Dragonyx118/LegmaMiteo/firmware/LegmaMiteo_Documentazione_Firmware.docx

# LegmaMiteo — Firmware Stazione base

Stazione-001-V2 — BMP180 + SD + MQTT su TLS + Deep Sleep

# 1. Panoramica

Questo documento descrive il funzionamento del firmware della stazione meteo base del progetto LegmaMiteo, basato su ESP32-S3-WROOM-1-N16R8. La stazione legge un dato di temperatura/pressione dal sensore BMP180, lo invia via MQTT (su TLS, tramite Tailscale Funnel) e, se la rete non è disponibile, lo salva in coda su microSD per un invio successivo. Il ciclo di funzionamento si basa interamente sul deep sleep: ad ogni risveglio la scheda riparte da un reset completo (WiFi e MQTT si riconnettono da zero), mentre alcune variabili sopravvivono al sonno grazie alla RTC memory.

# 2. Architettura del ciclo

Non esiste un loop continuo: la funzione loop() non viene mai eseguita. Tutta la logica gira dentro setup(), che al termine chiama sempre goToDeepSleep(). Ad ogni risveglio la sequenza è:

- Avvio seriale e LED RGB (il colore precedente resta acceso finché non viene aggiornato)
- Impostazione del fuso orario (configTime), sempre, anche senza WiFi
- Inizializzazione I2C (BMP180) e SPI (microSD)
- Configurazione del client MQTT (server, buffer, timeout)
- Tentativo di connessione WiFi, poi MQTT
- Lettura del sensore e invio o salvataggio locale del dato live
- Se la connessione MQTT è attiva, invio del backlog accumulato su SD
- Disconnessione pulita e ingresso in deep sleep per il tempo restante del ciclo (10 secondi target)

# 3. Piedinatura (pin mapping)

Funzione | Pin GPIO | Note
I2C SDA (BMP180) | 4
I2C SCL (BMP180) | 5
SPI MISO (SD) | 16
SPI CLK (SD) | 17
SPI MOSI (SD) | 15
Chip Select SD | 18
LED RGB WS2812 | 48 | 38 su alcuni cloni (es. Freenove)

# 4. Gestione del tempo (NTP + fallback HTTP)

La sincronizzazione dell'orario avviene tramite NTP (time.google.com, con pool.ntp.org e time.cloudflare.com come server secondari passati a configTime). Il flag timeSynchronized, conservato in RTC memory, evita di ripetere la sincronizzazione NTP ad ogni ciclo una volta riuscita.

Se NTP fallisce (tipico su reti che filtrano UDP, come un hotspot Windows con ICS), il firmware tenta un fallback via HTTPS verso timeapi.io, che restituisce l'orario in JSON e lo imposta manualmente con settimeofday().

Nota importante: configTime() viene chiamato incondizionatamente all'inizio di ogni ciclo, anche se timeSynchronized è già true, altrimenti l'offset GMT+DST non verrebbe applicato correttamente nel boot corrente e i timestamp salvati su SD risulterebbero sfasati.

# 5. Connessione WiFi e diagnostica LED

La connessione WiFi viene tentata una sola volta per ciclo (nessun retry loop prolungato, per non consumare batteria). In caso di fallimento, il firmware distingue due situazioni tramite una scansione delle reti visibili (ssidVisibileInAria):

- Rete non rilevata nell'aria → LED viola/magenta (router spento o fuori portata)
- Rete rilevata ma connessione fallita → LED rosso (segnale instabile o credenziali errate)

In caso di successo, il colore del LED riflette la qualità del segnale (RSSI):

Colore | Significato | Condizione
Blu/Azzurro | Segnale WiFi perfetto | RSSI ≥ -55 dBm
Verde | Segnale WiFi ottimo | RSSI ≥ -65 dBm
Giallo | Segnale WiFi medio | RSSI ≥ -75 dBm
Rosso | Segnale WiFi scarso, oppure rete rilevata ma connessione fallita | RSSI < -75 dBm
Viola/Magenta | SSID configurato non rilevato nell'aria | Router spento o fuori portata
Arancione | WiFi OK ma broker MQTT non raggiungibile | Server/tunnel/credenziali

# 6. Connessione MQTT su TLS

Il broker MQTT è raggiunto tramite Tailscale Funnel in modalità tls-terminated-tcp: dall'esterno risulta un endpoint pubblico su porta 8443, con TLS terminato da Tailscale usando un certificato pubblico valido. Internamente il traffico prosegue in chiaro verso Mosquitto sulla porta 1883.

Nel firmware questo si traduce in un normale WiFiClientSecure. Attualmente è impostato setInsecure(), che salta la verifica del certificato: utile in fase di test, ma per un deployment definitivo andrebbe sostituito con setCACert() puntato alla root CA reale. Il timeout del client è impostato a 10 secondi per assorbire il tempo aggiuntivo dell'handshake TLS.

Se il WiFi funziona ma la connessione MQTT fallisce, il LED passa ad arancione: questo colore è distinto dalla scala verde/giallo/rosso del segnale WiFi, perché segnala un problema più a monte (server spento, tunnel caduto, credenziali errate) e non di potenza del segnale.

# 7. Gestione del backlog su microSD

Quando l'invio MQTT non è possibile, il dato viene scritto in append nel file /backup.jsonl (una riga JSON per lettura). Quando la connessione torna disponibile, la funzione svuotaCodaSD() invia i dati accumulati.

Il punto chiave dell'ottimizzazione è l'offset persistente sdReadOffset, salvato in RTC memory: invece di ricopiare l'intero file ad ogni ciclo, il firmware riprende la lettura esattamente da dove si era fermato con file.seek(sdReadOffset). Questo ha ridotto il tempo di ciclo da circa 43 secondi a circa 7 secondi nei test.

Alcuni dettagli di comportamento:

- L'invio da SD ha un budget di tempo di 6 secondi per ciclo (SD_FLUSH_TIME_BUDGET_MS), non un numero fisso di righe: con connessione buona vengono inviati più dati nello stesso tempo
- Tra un invio e l'altro c'è una pausa di 50ms per non sovraccaricare la pipeline Mosquitto → Telegraf → InfluxDB → Grafana
- L'offset avanza SOLO dopo un invio riuscito: se la connessione cade a metà, la riga non inviata viene ritentata al ciclo successivo
- Se il file viene svuotato completamente, viene eliminato subito con SD.remove()
- Una compattazione fisica del file avviene solo periodicamente, ogni 200KB di dati processati (SD_COMPACT_THRESHOLD_BYTES), per ammortizzare il costo della riscrittura su molti cicli invece di farla ogni volta

# 8. Acquisizione dati e pubblicazione

La funzione handleDataCycle() legge temperatura e pressione dal BMP180 e costruisce un payload JSON con ArduinoJson. I campi di umidità, luce, vento e pioggia sono presenti nello schema ma non ancora popolati da sensori reali (impostati a 0.0), in previsione dei moduli aggiuntivi MOD-AIR e sensori esterni.

Se la connessione MQTT è attiva, il dato viene pubblicato subito sul topic station/<STATION_ID>/base. Solo se la pubblicazione fallisce o MQTT non è disponibile, il dato viene scritto su SD. La lettura live viene sempre gestita prima dello svuotamento del backlog SD, per evitare che un backlog lungo ritardi il dato più recente.

# 9. Deep sleep e durata del ciclo

Il ciclo target è di 10 secondi (CYCLE_DURATION_US). La funzione goToDeepSleep() calcola quanto tempo è stato effettivamente impiegato in fase attiva (boot, connessioni, lettura sensore, invio dati) e sottrae questo valore dalla durata target, così l'intervallo tra due letture resta vicino ai 10 secondi indipendentemente da quanto tempo la scheda è rimasta sveglia. È previsto un tempo minimo di sonno di 2 secondi come garanzia di sicurezza.

Il LED RGB non viene spento prima del deep sleep: mantiene l'ultimo colore mostrato, restando visibile anche durante il sonno senza bisogno di alimentazione continua sul pin.

# 10. Osservazioni per il miglioramento della stabilità

Punti da tenere presenti per rendere la connessione della stazione più stabile:

- setInsecure() su MQTT va sostituito con setCACert() per una verifica certificato reale in produzione
- Il singolo tentativo di connessione WiFi/MQTT per ciclo (8 tentativi da 500ms) è volutamente breve per risparmiare batteria: in caso di reti instabili, si potrebbe valutare un numero di retry variabile o un backoff
- Il timeout MQTT di 10s con TLS può risultare stretto su reti molto lente; da monitorare in campo
- Il buffer PubSubClient è impostato a 512 byte per l'overhead TLS: da verificare se sufficiente con payload più grandi (es. MOD-AIR con più sensori)
- La sincronizzazione NTP viene ritentata solo se timeSynchronized è false: un power-cycle completo (non solo deep sleep) resetta questo flag
