Dragonyx118/LegmaMiteo/3Dmodels/anemometer-wind-direction/MainSeal.stl

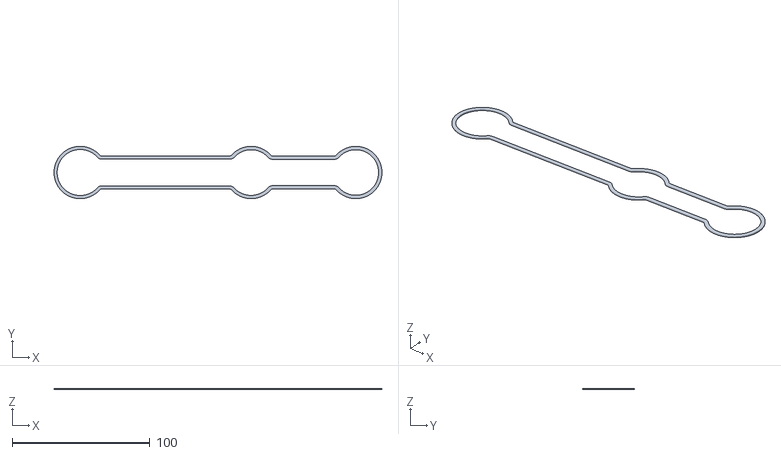
[picture p4: CAD file, 2026-11-05]
3Dmodels/anemometer-wind-direction/MainSeal.stl
238.0 x 38.0 x 1.00
