Dragonyx118/LegmaMiteo/3Dmodels/anemometer-wind-direction/WindVaneSeal.stl

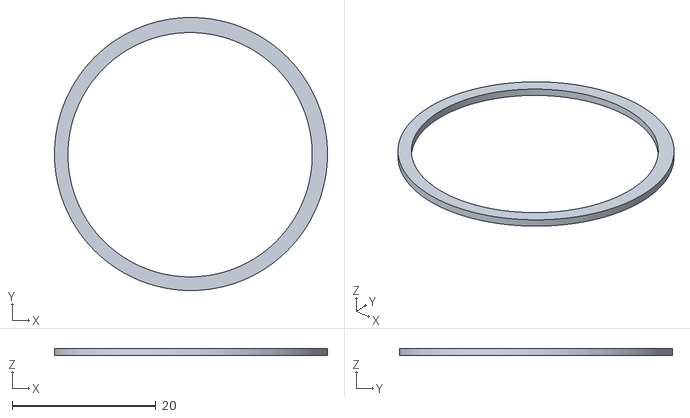
[picture p5: CAD file, 2026-11-05]
3Dmodels/anemometer-wind-direction/WindVaneSeal.stl
38.0 x 38.0 x 1.00
