Dragonyx118/LegmaMiteo/3Dmodels/rain-gauge/RainSeals.3mf

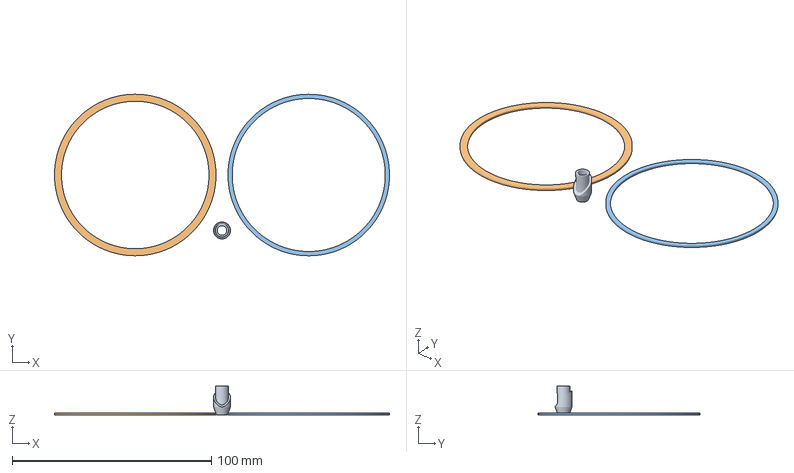
[picture p6: CAD file, 2026-11-05]
3Dmodels/rain-gauge/RainSeals.3mf
168.0 x 81.0 x 14.5 mm
CableSeal.stl
RainGaugeBaseSeal.stl
RainGaugeSeal.stl
