Dragonyx118/LegmaMiteo/3Dmodels/anemometer-wind-direction/SensorMount.stl

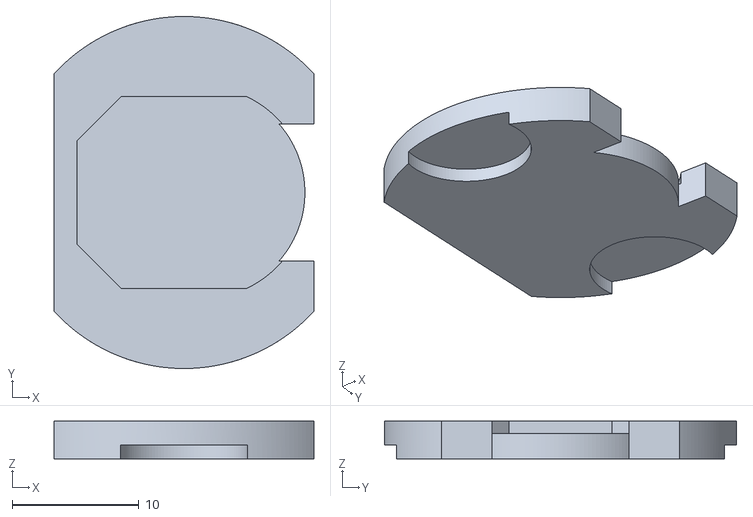
[picture p7: CAD file, 2026-11-05]
3Dmodels/anemometer-wind-direction/SensorMount.stl
20.5 x 27.8 x 3.00
