Dragonyx118/LegmaMiteo/3Dmodels/rain-gauge/RainGaugeBase.stl

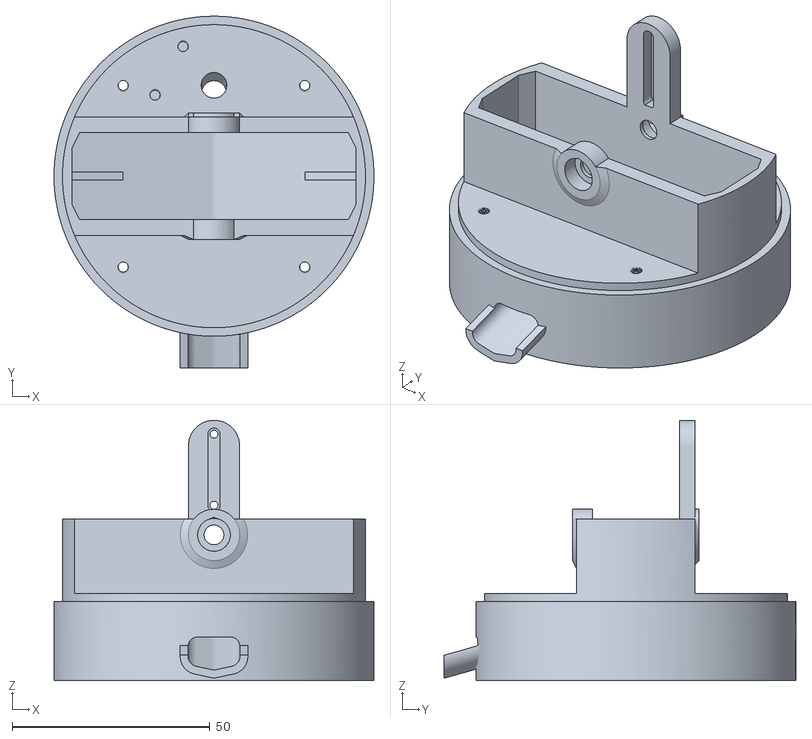
[picture p8: CAD file, 2026-11-05]
3Dmodels/rain-gauge/RainGaugeBase.stl
81.0 x 89.0 x 65.9
