Dragonyx118/LegmaMiteo/3Dmodels/anemometer-wind-direction/VaneReedMount.stl

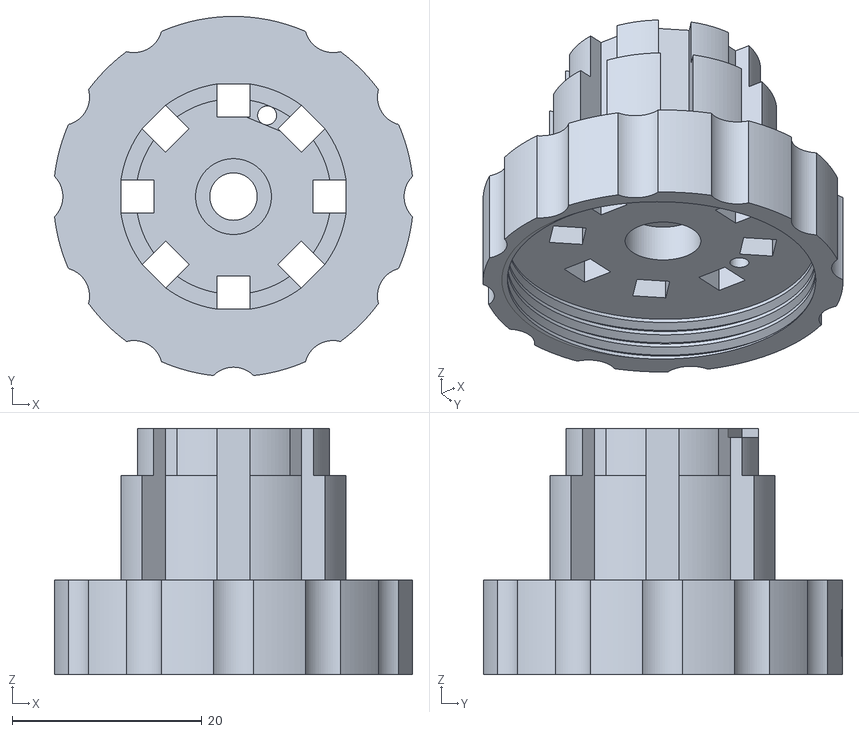
[picture p9: CAD file, 2026-11-05]
3Dmodels/anemometer-wind-direction/VaneReedMount.stl
37.8 x 37.9 x 26.0
