Dragonyx118/LegmaMiteo/3Dmodels/rain-gauge/RainGaugeBaseBottom.stl

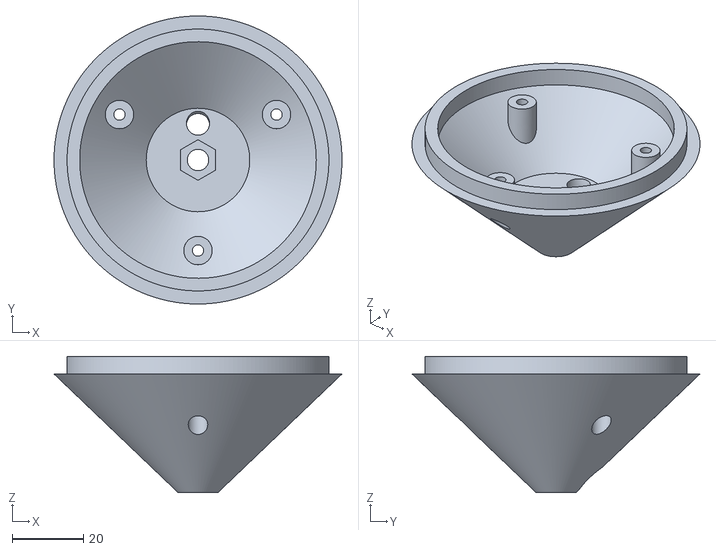
[picture p10: CAD file, 2026-11-05]
3Dmodels/rain-gauge/RainGaugeBaseBottom.stl
81.0 x 81.0 x 38.4
