Dragonyx118/LegmaMiteo/3Dmodels/anemometer-wind-direction/AnemoReedMount.stl

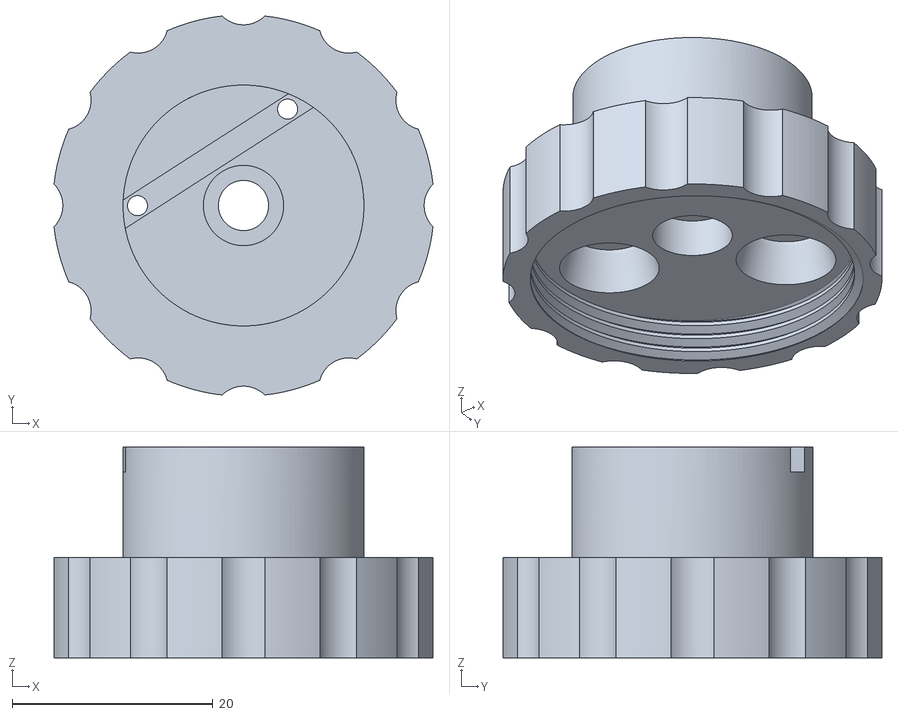
[picture p11: CAD file, 2026-11-05]
3Dmodels/anemometer-wind-direction/AnemoReedMount.stl
37.8 x 37.8 x 21.0
