Dragonyx118/LegmaMiteo/3Dmodels/rain-gauge/CableHolder.stl

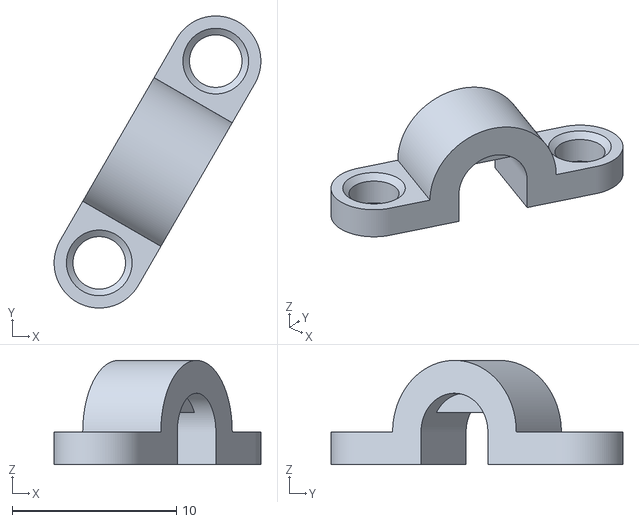
[picture p12: CAD file, 2026-11-05]
3Dmodels/rain-gauge/CableHolder.stl
12.6 x 17.8 x 6.35
