Dragonyx118/LegmaMiteo/3Dmodels/anemometer-wind-direction/VaneMount.stl

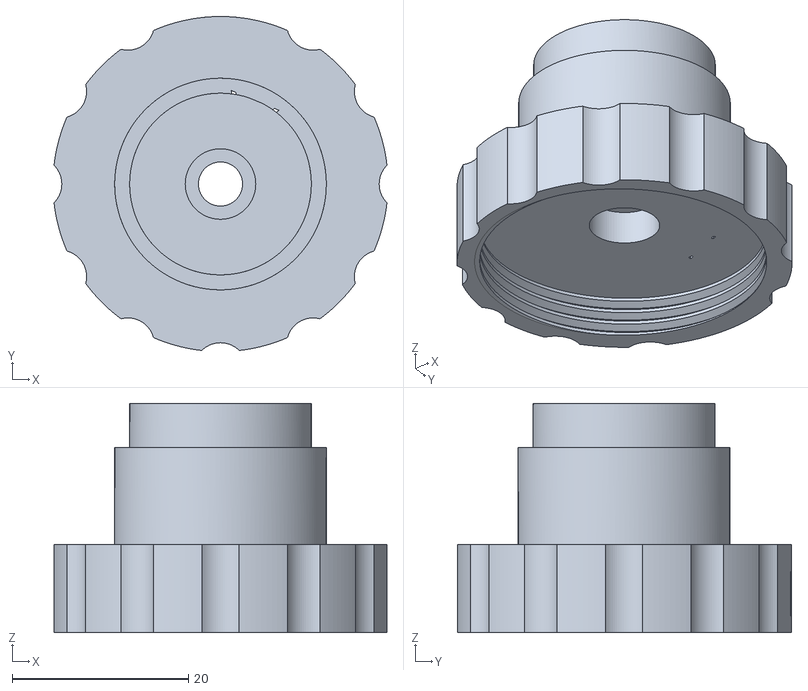
[picture p13: CAD file, 2026-11-05]
3Dmodels/anemometer-wind-direction/VaneMount.stl
37.8 x 37.9 x 26.0
