Dragonyx118/LegmaMiteo/3Dmodels/anemometer-wind-direction/WindMountBottom.stl

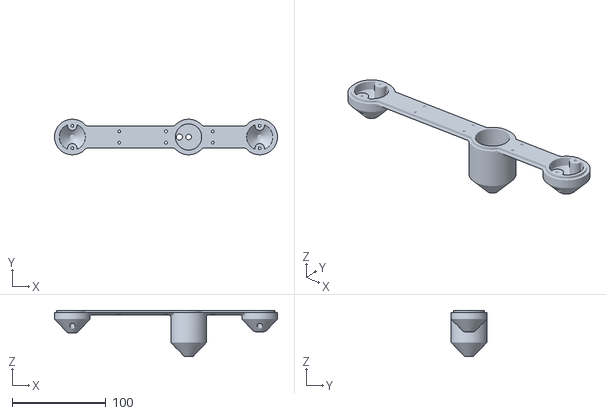
[picture p15: CAD file, 2026-11-05]
3Dmodels/anemometer-wind-direction/WindMountBottom.stl
238.0 x 38.0 x 49.3
