Dragonyx118/LegmaMiteo/3Dmodels/rain-gauge/CableSeal.stl

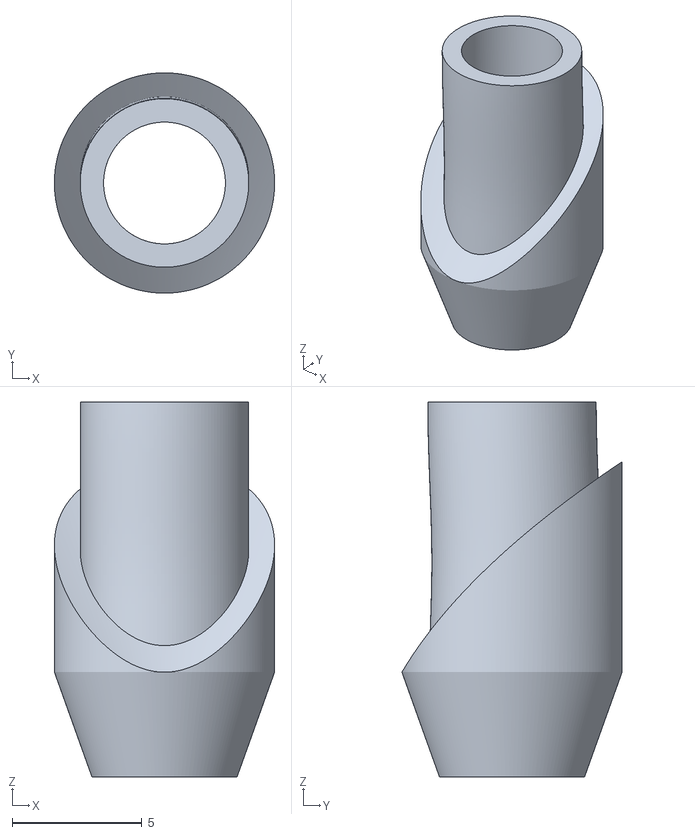
[picture p16: CAD file, 2026-11-05]
3Dmodels/rain-gauge/CableSeal.stl
8.50 x 8.50 x 14.5
