Dragonyx118/LegmaMiteo/3Dmodels/anemometer-wind-direction/VaneReedOption.3mf

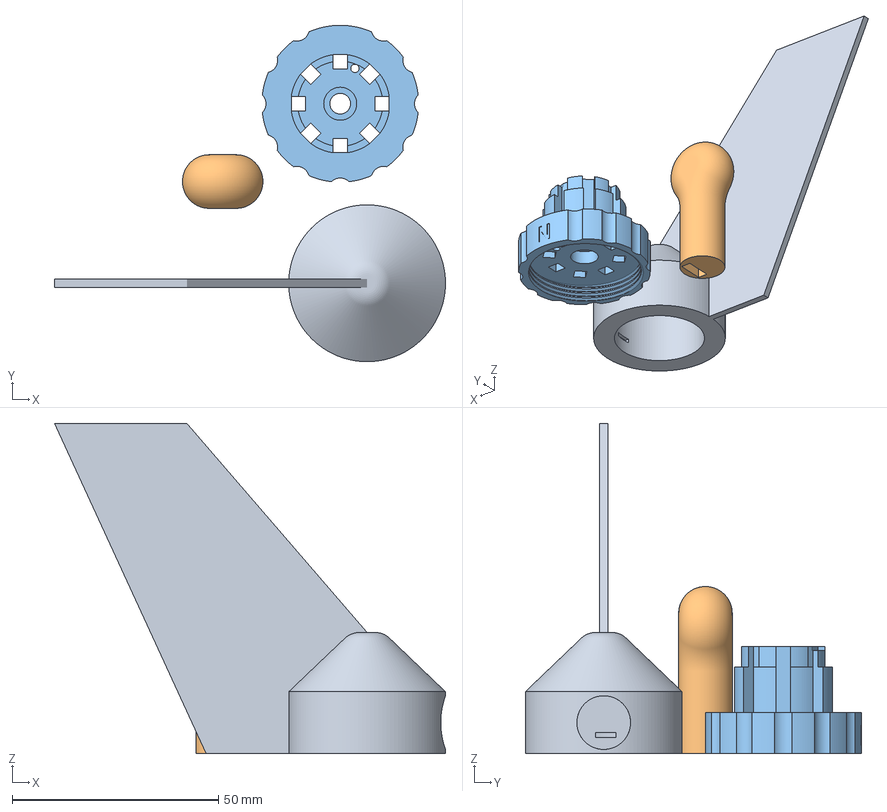
[picture p17: CAD file, 2026-11-05]
3Dmodels/anemometer-wind-direction/VaneReedOption.3mf
94.8 x 81.5 x 80.0 mm
Vane.stl
VaneTip.stl
VaneReedMount.stl
