Dragonyx118/LegmaMiteo/3Dmodels/rain-gauge/Gauge.stl

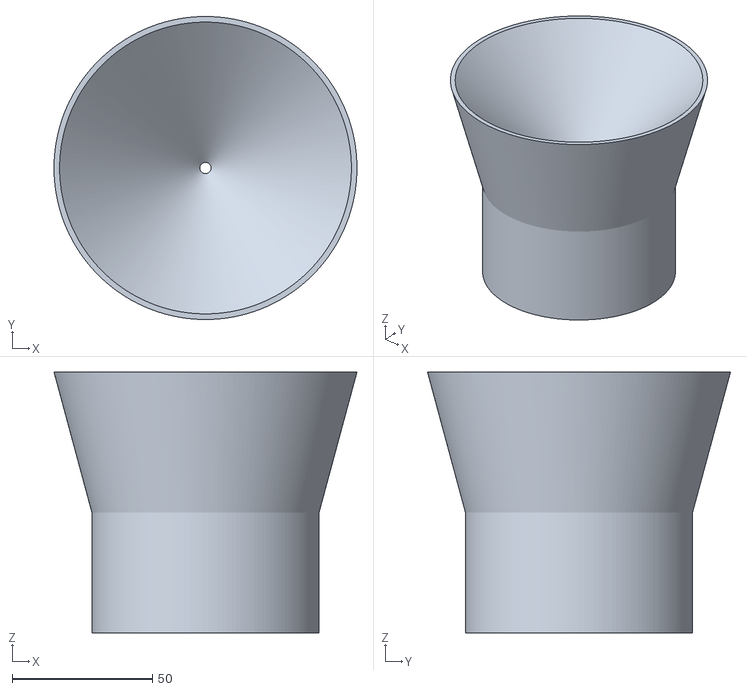
[picture p18: CAD file, 2026-11-05]
3Dmodels/rain-gauge/Gauge.stl
108.0 x 108.0 x 92.9
