Dragonyx118/LegmaMiteo/3Dmodels/anemometer-wind-direction/AnemoFlyersMount.stl

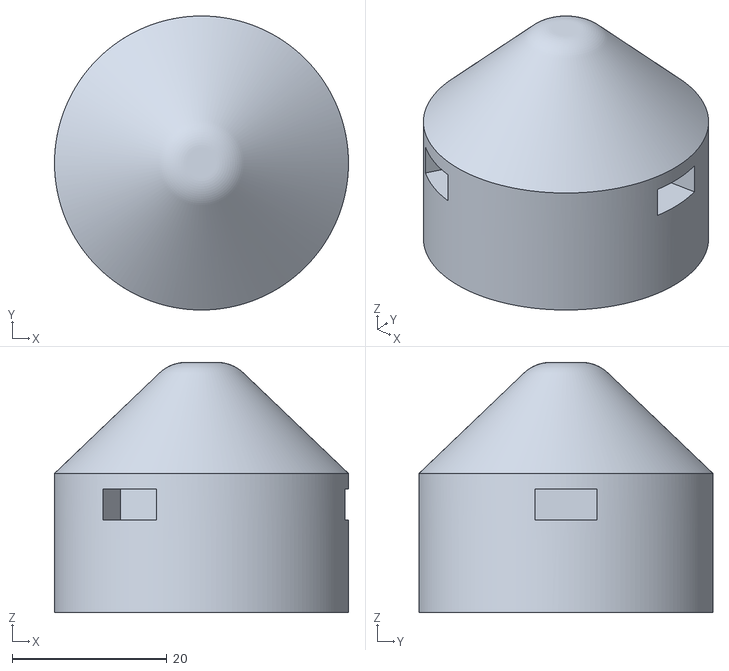
[picture p19: CAD file, 2026-11-05]
3Dmodels/anemometer-wind-direction/AnemoFlyersMount.stl
38.0 x 38.0 x 32.3
