Dragonyx118/LegmaMiteo/3Dmodels/rain-gauge/RainGauge.3mf

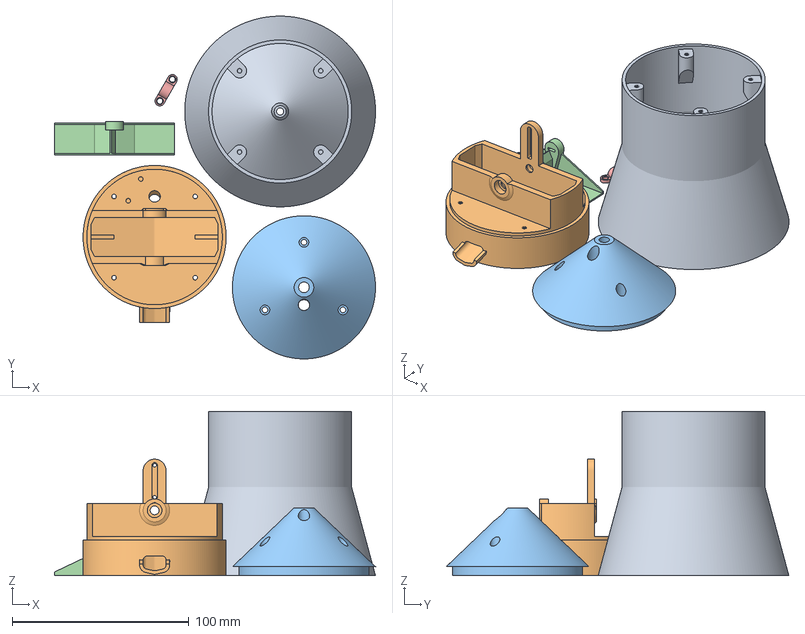
[picture p20: CAD file, 2026-11-05]
3Dmodels/rain-gauge/RainGauge.3mf
181.7 x 194.1 x 92.9 mm
Gauge.stl
RainGaugeBase.stl
RainGaugeBaseBottom.stl
Bucket.stl
CableHolder.stl
