Dragonyx118/LegmaMiteo/3Dmodels/anemometer-wind-direction/Anemometer.3mf

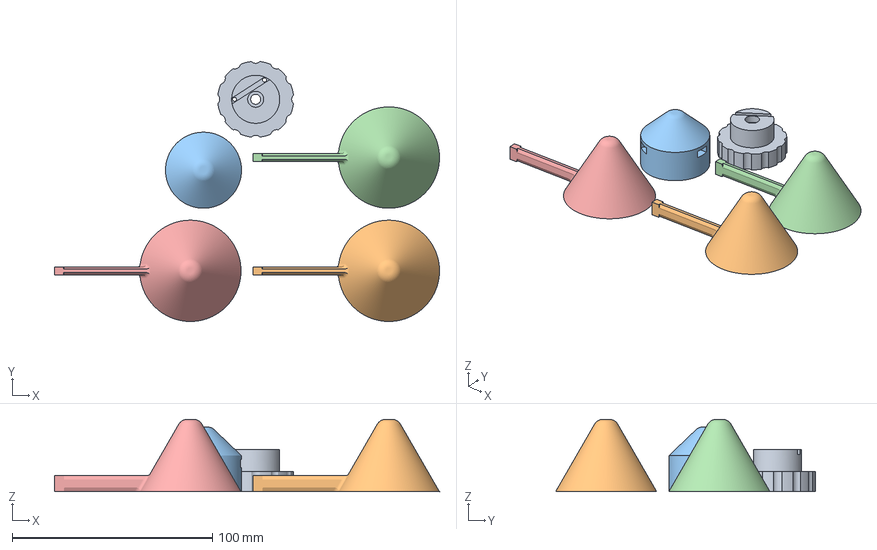
[picture p21: CAD file, 2026-11-05]
3Dmodels/anemometer-wind-direction/Anemometer.3mf
192.4 x 129.9 x 36.2 mm
AnemoReedMount.stl
AnemoFlyer.stl x 3
AnemoFlyersMount.stl
