Dragonyx118/LegmaMiteo/3Dmodels/rain-gauge/Bucket.stl

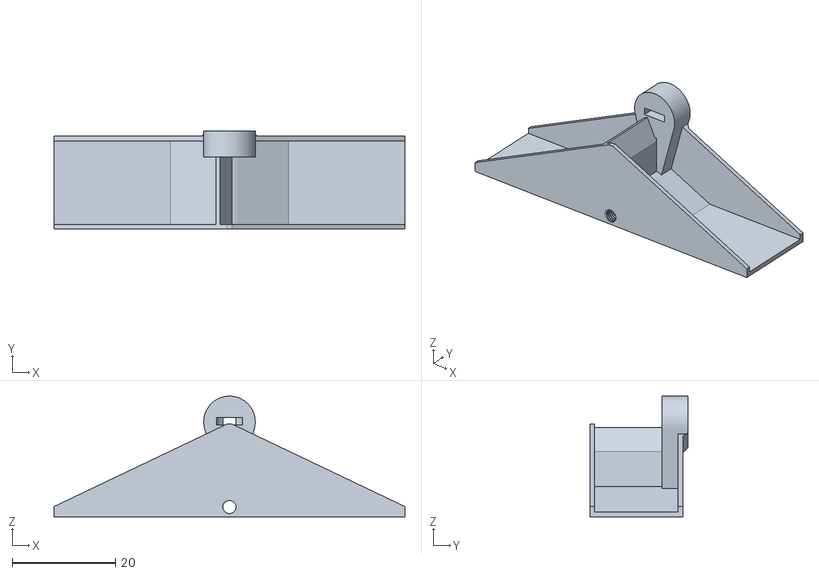
[picture p22: CAD file, 2026-11-05]
3Dmodels/rain-gauge/Bucket.stl
68.0 x 19.0 x 23.4
