Dragonyx118/LegmaMiteo/3Dmodels/anemometer-wind-direction/AnemoFlyer.stl

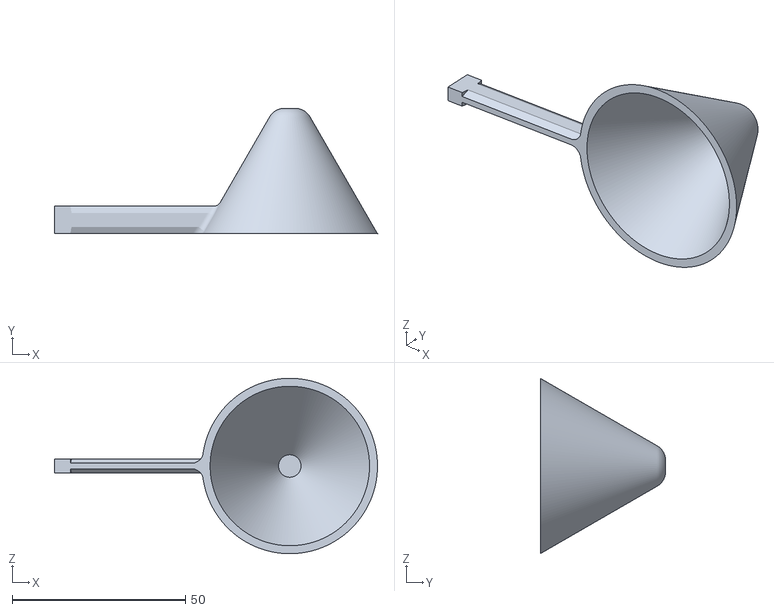
[picture p23: CAD file, 2026-11-05]
3Dmodels/anemometer-wind-direction/AnemoFlyer.stl
93.2 x 36.2 x 50.6
