Dragonyx118/LegmaMiteo/3Dmodels/rain-gauge/RainGaugeBaseSeal.stl

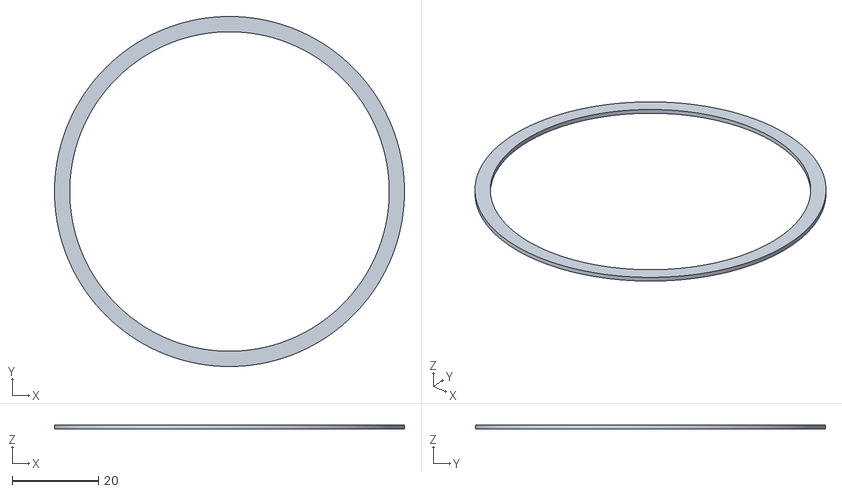
[picture p24: CAD file, 2026-11-05]
3Dmodels/rain-gauge/RainGaugeBaseSeal.stl
81.0 x 81.0 x 1.00
