Dragonyx118/LegmaMiteo/3Dmodels/anemometer-wind-direction/Vane.stl

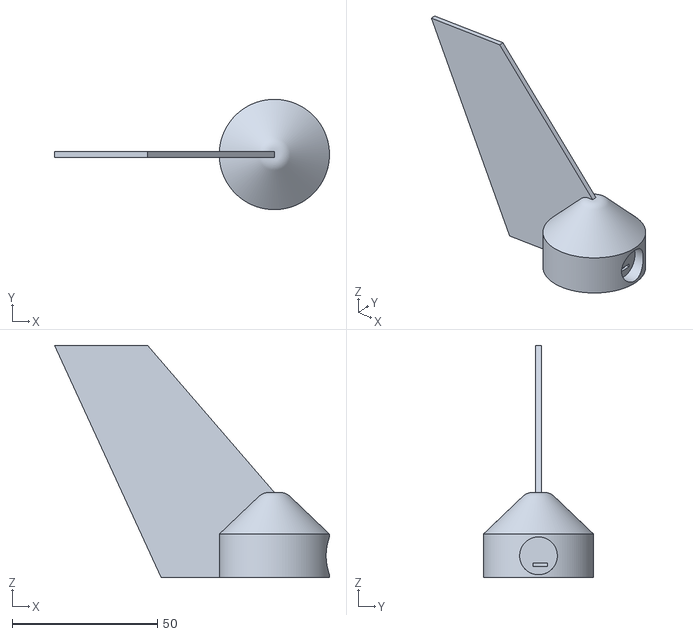
[picture p25: CAD file, 2026-11-05]
3Dmodels/anemometer-wind-direction/Vane.stl
94.8 x 38.0 x 80.0
