Dragonyx118/LegmaMiteo/3Dmodels/anemometer-wind-direction/WindMountTop.stl

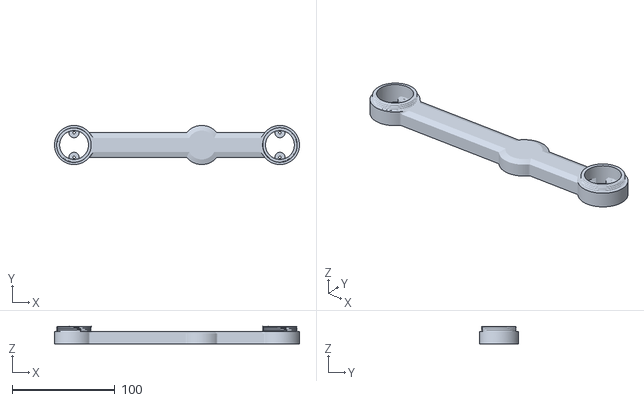
[picture p26: CAD file, 2026-11-05]
3Dmodels/anemometer-wind-direction/WindMountTop.stl
238.0 x 38.0 x 17.0
