Dragonyx118/LegmaMiteo/3Dmodels/anemometer-wind-direction/WindMount.3mf

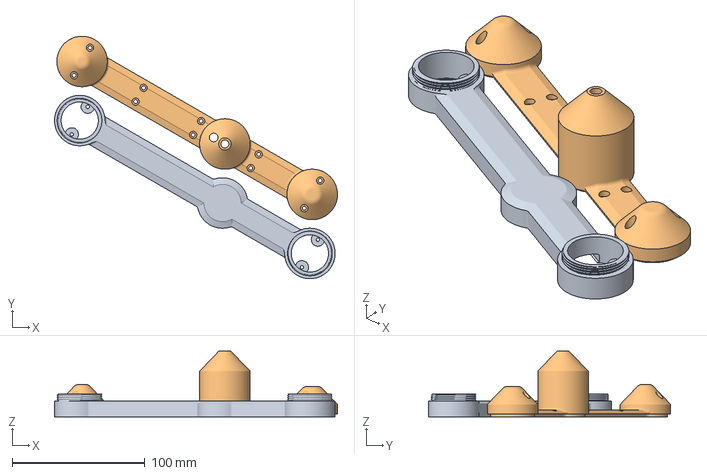
[picture p27: CAD file, 2026-11-05]
3Dmodels/anemometer-wind-direction/WindMount.3mf
213.0 x 182.4 x 49.3 mm
WindMountTop.stl
WindMountBottom.stl
