Dragonyx118/LegmaMiteo/3Dmodels/anemometer-wind-direction/VaneAS5600Option.3mf

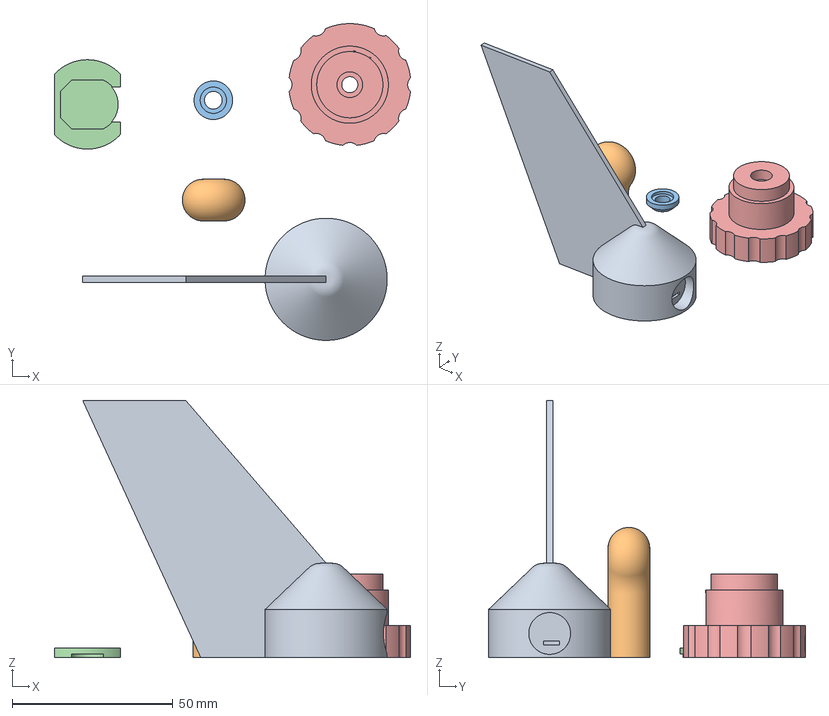
[picture p28: CAD file, 2026-11-05]
3Dmodels/anemometer-wind-direction/VaneAS5600Option.3mf
110.8 x 98.6 x 80.0 mm
Vane.stl
VaneTip.stl
MagnetMount.stl
SensorMount.stl
VaneMount.stl
