Dragonyx118/LegmaMiteo/3Dmodels/anemometer-wind-direction/MagnetMount.stl

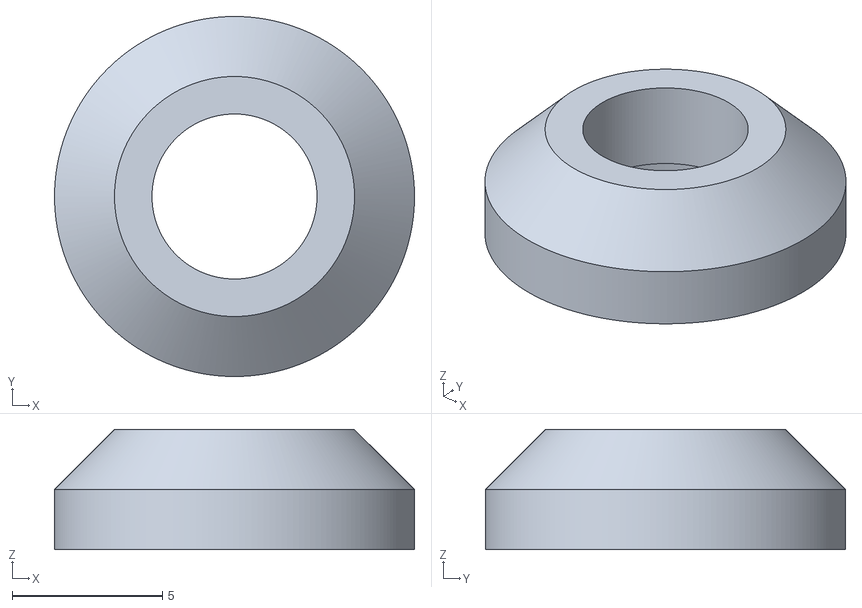
[picture p29: CAD file, 2026-11-05]
3Dmodels/anemometer-wind-direction/MagnetMount.stl
12.0 x 12.0 x 4.00
