Dragonyx118/LegmaMiteo/3Dmodels/anemometer-wind-direction/WindSeals.3mf

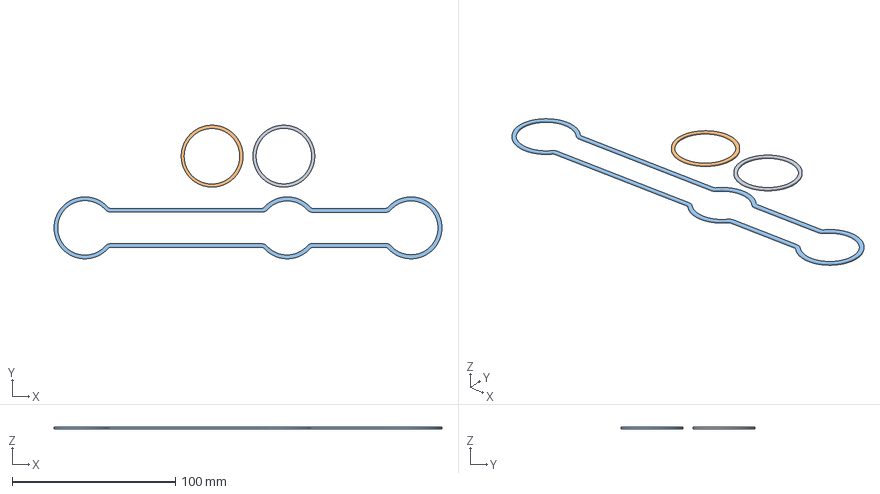
[picture p30: CAD file, 2026-11-05]
3Dmodels/anemometer-wind-direction/WindSeals.3mf
238.0 x 82.0 x 1.00 mm
AnemoSeal.stl
WindVaneSeal.stl
MainSeal.stl
