Dragonyx118/LegmaMiteo/3Dmodels/anemometer-wind-direction/VaneTip.stl

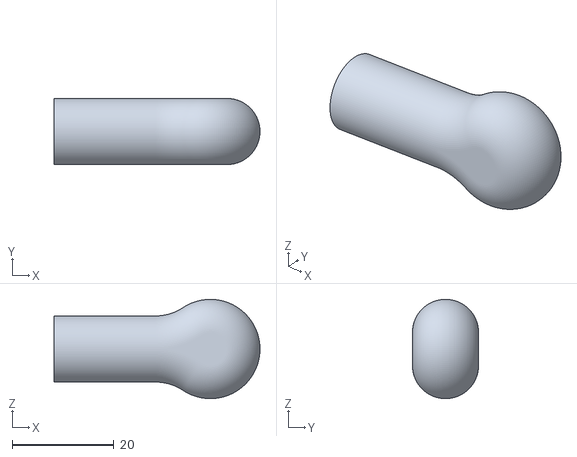
[picture p31: CAD file, 2026-11-05]
3Dmodels/anemometer-wind-direction/VaneTip.stl
40.5 x 13.0 x 19.5
