Dragonyx118/LegmaMiteo/(list of files, cad)

Other CAD files:
3Dmodels/rain-gauge/RainGaugeBase_Custom.stl
