Dragonyx118/LegmaMiteo/(commit log)

2026-06-11 Feat: add ESP32 firmware with simulated data
2026-06-21 Fix: range dinamico Grafana (v.timeRangeStart/timeRangeStop) nelle dashboard storiche
2026-06-21 Implemented deep sleep in the base firmware
    [PCBbase.kicad_pcb, PCBbase.kicad_sch]
2026-06-23 Updated BASE dashboards with more visible humidity and pressure graphs
2026-06-27 Updated dashboards with aggragateWindow and fixed firmware
    [main.cpp]
2026-07-07 refactor: svuotamento SD con offset persistente (RTC) + compattazione periodica invece di ricopiare il backlog ad ogni ciclo, riducendo il ciclo attivo da ~43s a ~7s, everything on the new board ESP3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
2026-07-08 Aggiunge installer server e workflow di release
2026-07-18 Fix firmware sleep and lower update frequency when good weather
    [main.cpp]
2026-07-21 Universal Fix for DNS resolve
    [main.cpp]
2026-08-20 Connection fix: external DNS fallback, correct escalation counter, extended SD recovery, watchdog in compaction, stable range 30s
    [main.cpp]
2026-09-19 Aggiorna .gitignore, rimuovi secrets.h dal tracking e aggiorna il bot
2026-10-15 Updated forecast to 5 days and with new sensors
2026-10-28 First tests with new sensors
2026-10-29 Test fix interferences from jumpers of test breadboard with SPI protocol
2026-10-30 Working sensors exept AS3935 in the works
2026-10-30 feat: Working updated firmware with new sensors and sd card / old features also working
2026-10-30 Working grafana and InfluxDB with new sensors
2026-11-01 Added perceived temperature, and sunrise and sunset in backend and forntend, updated VENV
2026-11-01 Added and fixed public FastAPI for Perceived Temperature
2026-11-05 Added 3dmodels for pluviometer and wind speed/direction sensors, updated tailscale certificate with correct name and position
2026-11-13 Updated dashboard for low pressure better graphics and new dashboard image for README
